andyroggenbuck/LED-Control/images/LED Controller schematic-page-001.jpg

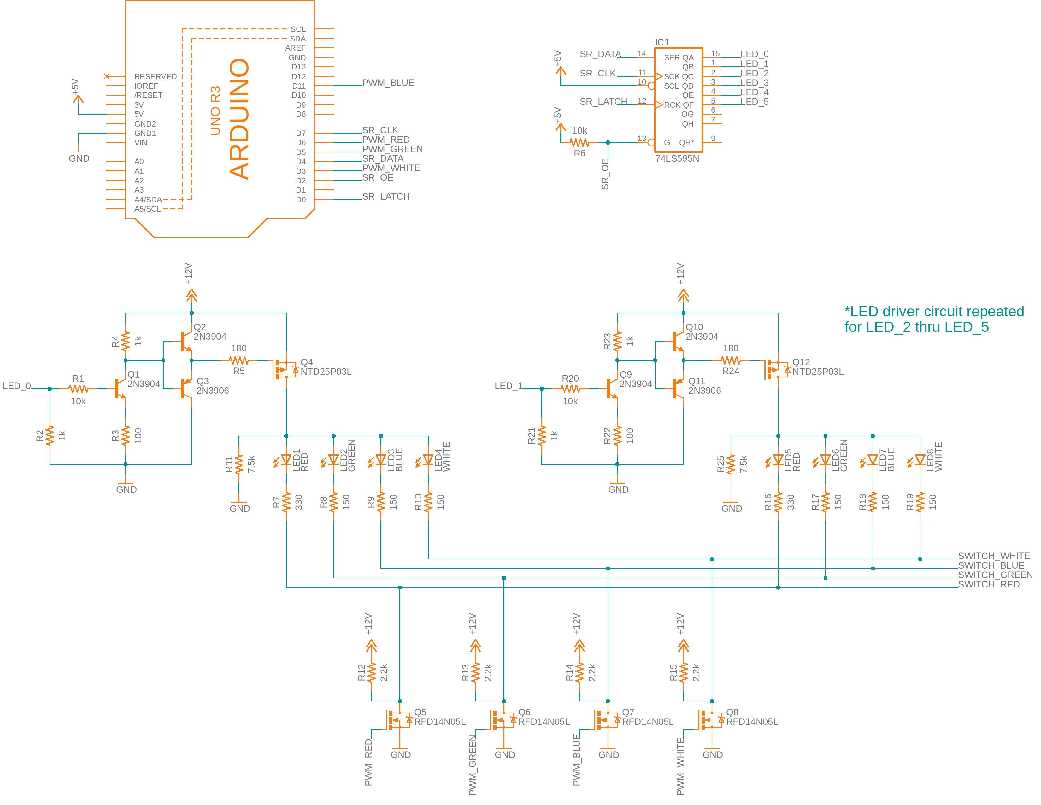
images/LED Controller schematic-page-001.jpg
