andyroggenbuck/LED-Control/(commit log)

2020-12-07 Timer modules & interrupts implemented. LED multiplexing now works.
2020-12-14 add schematic pdf to readme
2020-12-14 add schematic jpg
2020-12-14 add schematic jpg to readme
2020-12-14 add schematic in images folder
2020-12-15 updated schematic pdf
2020-12-15 change schematic jpg to pdf
2020-12-15 schematic images updated
2022-10-09 Add schematic v2
